ovrEngineered/ovrBeaconGateway-wifi-elec/bom/ovrBeaconGateway-wifi_pricing.xlsx

Sheet: Standalone Low-Power BTLE
Reference | Manufacturer | Man. Part Num. | Supplier | Supplier Part Num. | Quantity | Price (qty 1) | Subtotal (qty 1) | Price (qty 1000) | Subtotal (qty 1000)
J2 | Pulse Electronics | E6588-52L184-L | Digi-Key | 553-2265-ND | 0 | $1.40 | $0.00 | $0.774400 | $0.000000
U2 | Torex Semiconductor | XC6210B332MR-G | Digi-Key | 893-1075-1-ND | 1 | $0.88 | $0.88 | $0.351020 | $0.351020
D3 | Cree Inc. | CLV1A-FKB-CK1N1G1BB7R4S3 | Digi-Key | CLV1A-FKB-CK1N1G1BB7R4S3CT-ND | 1 | $0.74 | $0.74 | $0.486200 | $0.486200
U1 | Silicon Labs | SI7050-A20-IM | Digi-Key | 336-3118-5-ND | 1 | $1.25 | $1.25 | $0.939300 | $0.939300
U5 | Intersil | ISL32602EFBZ | Digi-Key | ISL32602EFBZ-ND | 0 | $3.18 | $0.00 | $1.680000 | $0.000000
U3 | FTDI | FT232RL | Digi-Key | 768-1007-1-ND | 1 | $4.50 | $4.50 | $2.850000 | $2.850000
R8 R9 R10 | Vishay_Dale | CRCW060312K0FKEA | Digi-Key | 541-12.0KHCT-ND | 3 | $0.10 | $0.30 | $0.005540 | $0.016620
C1 C2 C3 | Murata | GRM21BR71A106KE51L | Digi-Key | 490-3905-1-ND | 3 | $0.24 | $0.72 | $0.050500 | $0.151500
D1 | Lite-On Inc | LTST-C193KGKT-5A | Digi-Key | 160-1828-1-ND | 1 | $0.41 | $0.41 | $0.075650 | $0.075650
D2 | Lite-On Inc | LTST-C193KRKT-5A | Digi-Key | 160-1830-1-ND | 1 | $0.41 | $0.41 | $0.075650 | $0.075650
R3 R4 R5 R2 R1 R18 | Vishay_Dale | CRCW0603402RFKEA | Digi-Key | 541-402HCT-ND | 6 | $0.10 | $0.60 | $0.003610 | $0.021660
R11 | Vishay_Dale | CRCW06035K10FKEA | Digi-Key | 541-5.10KHCT-ND | 1 | $0.10 | $0.10 | $0.005540 | $0.005540
R13 R12 R7 R6 R15 R14 | Vishay_Dale | CRCW060310K0FKEA | Digi-Key | 541-10.0KHCT-ND | 2 | $0.10 | $0.20 | $0.003610 | $0.007220
Q3 | International Rectifier | DMC6040SSD-13 | Digi-Key | DMC6040SSD-13DICT-ND | 0 | $0.65 | $0.00 | $0.275550 | $0.000000
Q1 Q2 | Micro Commercial Co | MMSS8050-H-TP | Digi-Key | MMSS8050-H-TPMSCT-ND | 2 | $0.20 | $0.40 | $0.003954 | $0.007908
U4 | EspressIf | esp-wroom-32 | Grid Connect | GC-ESP-WROOM-32 | 1 | $3.95 | $3.95 | $3.950000 | $3.950000
D4 | Lite-On Inc | LTST-C193TBKT-5A | Digi-Key | 160-1827-1-ND | 1 | $0.47 | $0.47 | $0.085770 | $0.085770
J1 | CUI Inc | UJ2-MIBH-4-SMT | Digi-Key | 102-4006-1-ND | 1 | $1.05 | $1.05 | $0.649440 | $0.649440
U6 | BlueGiga | BLE121LR-A-M256K | Digi-Key | 1446-1039-1-ND | 0 | $13.76 | $0.00 | $8.312320 | $0.000000
C4 | Murata | GRM188R71C104KA01D | Digi-Key | 490-1532-1-ND | 0 | $0.10 | $0.00 | $0.004730 | $0.000000
LightPipe | Visual Communications Company | LFB100CTP | Digi-Key | LFB100CTP-ND | 4 | $0.59 | $2.36 | $0.144040 | $0.576160
Case | PolyCase | LP-41F | PolyCase | LP-41F | 1 | $3.36 | $3.36 | $2.250000 | $2.250000
Case Print/Machining | PolyCase |  |  |  | 1 |  |  | $4.890000 | $4.890000
PCB |  |  |  |  | 1 |  |  | $1.000000 | $1.000000
Assembly |  |  |  |  | 1 |  |  | $2.000000 | $2.000000
 |  |  |  |  |  | Total: | $21.70 |  | $20.39

Sheet: Standalone High-Power BTLE
Reference | Manufacturer | Man. Part Num. | Supplier | Supplier Part Num. | Quantity | Price (qty 1) | Subtotal (qty 1) | Price (qty 1000) | Subtotal (qty 1000)
J2 | Pulse Electronics | E6588-52L184-L | Digi-Key | 553-2265-ND | 0 | $1.40 | $0.00 | $0.774400 | $0.000000
U2 | Torex Semiconductor | XC6210B332MR-G | Digi-Key | 893-1075-1-ND | 1 | $0.88 | $0.88 | $0.351020 | $0.351020
D3 | Cree Inc. | CLV1A-FKB-CK1N1G1BB7R4S3 | Digi-Key | CLV1A-FKB-CK1N1G1BB7R4S3CT-ND | 1 | $0.74 | $0.74 | $0.486200 | $0.486200
U1 | Silicon Labs | SI7050-A20-IM | Digi-Key | 336-3118-5-ND | 1 | $1.25 | $1.25 | $0.939300 | $0.939300
U5 | Intersil | ISL32602EFBZ | Digi-Key | ISL32602EFBZ-ND | 0 | $3.18 | $0.00 | $1.680000 | $0.000000
U3 | FTDI | FT232RL | Digi-Key | 768-1007-1-ND | 1 | $4.50 | $4.50 | $2.850000 | $2.850000
R8 R9 R10 | Vishay_Dale | CRCW060312K0FKEA | Digi-Key | 541-12.0KHCT-ND | 3 | $0.10 | $0.30 | $0.005540 | $0.016620
C1 C2 C3 | Murata | GRM21BR71A106KE51L | Digi-Key | 490-3905-1-ND | 3 | $0.24 | $0.72 | $0.050500 | $0.151500
D1 | Lite-On Inc | LTST-C193KGKT-5A | Digi-Key | 160-1828-1-ND | 1 | $0.41 | $0.41 | $0.075650 | $0.075650
D2 | Lite-On Inc | LTST-C193KRKT-5A | Digi-Key | 160-1830-1-ND | 1 | $0.41 | $0.41 | $0.075650 | $0.075650
R3 R4 R5 R2 R1 R18 | Vishay_Dale | CRCW0603402RFKEA | Digi-Key | 541-402HCT-ND | 6 | $0.10 | $0.60 | $0.003610 | $0.021660
R11 | Vishay_Dale | CRCW06035K10FKEA | Digi-Key | 541-5.10KHCT-ND | 1 | $0.10 | $0.10 | $0.005540 | $0.005540
R13 R12 R7 R6 R15 R14 | Vishay_Dale | CRCW060310K0FKEA | Digi-Key | 541-10.0KHCT-ND | 2 | $0.10 | $0.20 | $0.003610 | $0.007220
Q3 | International Rectifier | DMC6040SSD-13 | Digi-Key | DMC6040SSD-13DICT-ND | 0 | $0.65 | $0.00 | $0.275550 | $0.000000
Q1 Q2 | Micro Commercial Co | MMSS8050-H-TP | Digi-Key | MMSS8050-H-TPMSCT-ND | 2 | $0.20 | $0.40 | $0.003954 | $0.007908
U4 | EspressIf | esp-wroom-32 | Grid Connect | GC-ESP-WROOM-32 | 1 | $3.95 | $3.95 | $3.950000 | $3.950000
D4 | Lite-On Inc | LTST-C193TBKT-5A | Digi-Key | 160-1827-1-ND | 1 | $0.47 | $0.47 | $0.085770 | $0.085770
J1 | CUI Inc | UJ2-MIBH-4-SMT | Digi-Key | 102-4006-1-ND | 1 | $1.05 | $1.05 | $0.649440 | $0.649440
U6 | BlueGiga | BLE121LR-A-M256K | Digi-Key | 1446-1039-1-ND | 1 | $13.76 | $13.76 | $8.312320 | $8.312320
C4 | Murata | GRM188R71C104KA01D | Digi-Key | 490-1532-1-ND | 1 | $0.10 | $0.10 | $0.004730 | $0.004730
LightPipe | Visual Communications Company | LFB100CTP | Digi-Key | LFB100CTP-ND | 4 | $0.59 | $2.36 | $0.144040 | $0.576160
Case | PolyCase | LP-41F | PolyCase | LP-41F | 1 | $3.36 | $3.36 | $2.250000 | $2.250000
Case Print/Machining | PolyCase |  |  |  | 1 |  |  | $4.890000 | $4.890000
PCB |  |  |  |  | 1 |  |  | $1.000000 | $1.000000
Assembly |  |  |  |  | 1 |  |  | $2.000000 | $2.000000
 |  |  |  |  |  | Total: | $35.56 |  | $28.71

Sheet: External BTLE Extension
Reference | Manufacturer | Man. Part Num. | Supplier | Supplier Part Num. | Quantity | Price (qty 1) | Subtotal (qty 1) | Price (qty 1000) | Subtotal (qty 1000)
J2 | Pulse Electronics | E6588-52L184-L | Digi-Key | 553-2265-ND | 1 | $1.40 | $1.40 | $0.774400 | $0.774400
U2 | Torex Semiconductor | XC6210B332MR-G | Digi-Key | 893-1075-1-ND | 1 | $0.88 | $0.88 | $0.351020 | $0.351020
D3 | Cree Inc. | CLV1A-FKB-CK1N1G1BB7R4S3 | Digi-Key | CLV1A-FKB-CK1N1G1BB7R4S3CT-ND | 1 | $0.74 | $0.74 | $0.486200 | $0.486200
U1 | Silicon Labs | SI7050-A20-IM | Digi-Key | 336-3118-5-ND | 1 | $1.25 | $1.25 | $0.939300 | $0.939300
U5 | Intersil | ISL32602EFBZ | Digi-Key | ISL32602EFBZ-ND | 1 | $3.18 | $3.18 | $1.680000 | $1.680000
U3 | FTDI | FT232RL | Digi-Key | 768-1007-1-ND | 1 | $4.50 | $4.50 | $2.850000 | $2.850000
R8 R9 R10 | Vishay_Dale | CRCW060312K0FKEA | Digi-Key | 541-12.0KHCT-ND | 3 | $0.10 | $0.30 | $0.005540 | $0.016620
C1 C2 C3 | Murata | GRM21BR71A106KE51L | Digi-Key | 490-3905-1-ND | 3 | $0.24 | $0.72 | $0.050500 | $0.151500
D1 | Lite-On Inc | LTST-C193KGKT-5A | Digi-Key | 160-1828-1-ND | 1 | $0.41 | $0.41 | $0.075650 | $0.075650
D2 | Lite-On Inc | LTST-C193KRKT-5A | Digi-Key | 160-1830-1-ND | 1 | $0.41 | $0.41 | $0.075650 | $0.075650
R3 R4 R5 R2 R1 R18 | Vishay_Dale | CRCW0603402RFKEA | Digi-Key | 541-402HCT-ND | 6 | $0.10 | $0.60 | $0.003610 | $0.021660
R11 | Vishay_Dale | CRCW06035K10FKEA | Digi-Key | 541-5.10KHCT-ND | 1 | $0.10 | $0.10 | $0.005540 | $0.005540
R13 R12 R7 R6 R15 R14 | Vishay_Dale | CRCW060310K0FKEA | Digi-Key | 541-10.0KHCT-ND | 6 | $0.10 | $0.60 | $0.003610 | $0.021660
Q3 | International Rectifier | DMC6040SSD-13 | Digi-Key | DMC6040SSD-13DICT-ND | 1 | $0.65 | $0.65 | $0.275550 | $0.275550
Q1 Q2 | Micro Commercial Co | MMSS8050-H-TP | Digi-Key | MMSS8050-H-TPMSCT-ND | 2 | $0.20 | $0.40 | $0.003954 | $0.007908
U4 | EspressIf | esp-wroom-32 | Grid Connect | GC-ESP-WROOM-32 | 1 | $3.95 | $3.95 | $3.950000 | $3.950000
D4 | Lite-On Inc | LTST-C193TBKT-5A | Digi-Key | 160-1827-1-ND | 1 | $0.47 | $0.47 | $0.085770 | $0.085770
J1 | CUI Inc | UJ2-MIBH-4-SMT | Digi-Key | 102-4006-1-ND | 1 | $1.05 | $1.05 | $0.649440 | $0.649440
U6 | BlueGiga | BLE121LR-A-M256K | Digi-Key | 1446-1039-1-ND | 0 | $13.76 | $0.00 | $8.312320 | $0.000000
C4 | Murata | GRM188R71C104KA01D | Digi-Key | 490-1532-1-ND | 0 | $0.10 | $0.00 | $0.004730 | $0.000000
LightPipe | Visual Communications Company | LFB100CTP | Digi-Key | LFB100CTP-ND | 4 | $0.59 | $2.36 | $0.144040 | $0.576160
Case | PolyCase | LP-41F | PolyCase | LP-41F | 1 | $3.36 | $3.36 | $2.250000 | $2.250000
Case Print/Machining | PolyCase |  |  |  | 1 |  |  | $4.890000 | $4.890000
PCB |  |  |  |  | 1 |  |  | $1.000000 | $1.000000
Assembly |  |  |  |  | 1 |  |  | $2.000000 | $2.000000
 |  |  |  |  |  | Total: | $27.33 |  | $23.13
