ovrEngineered/ovrBeaconGateway-wifi-elec/output/ovrBeaconGateway-wifi_schematic.pdf

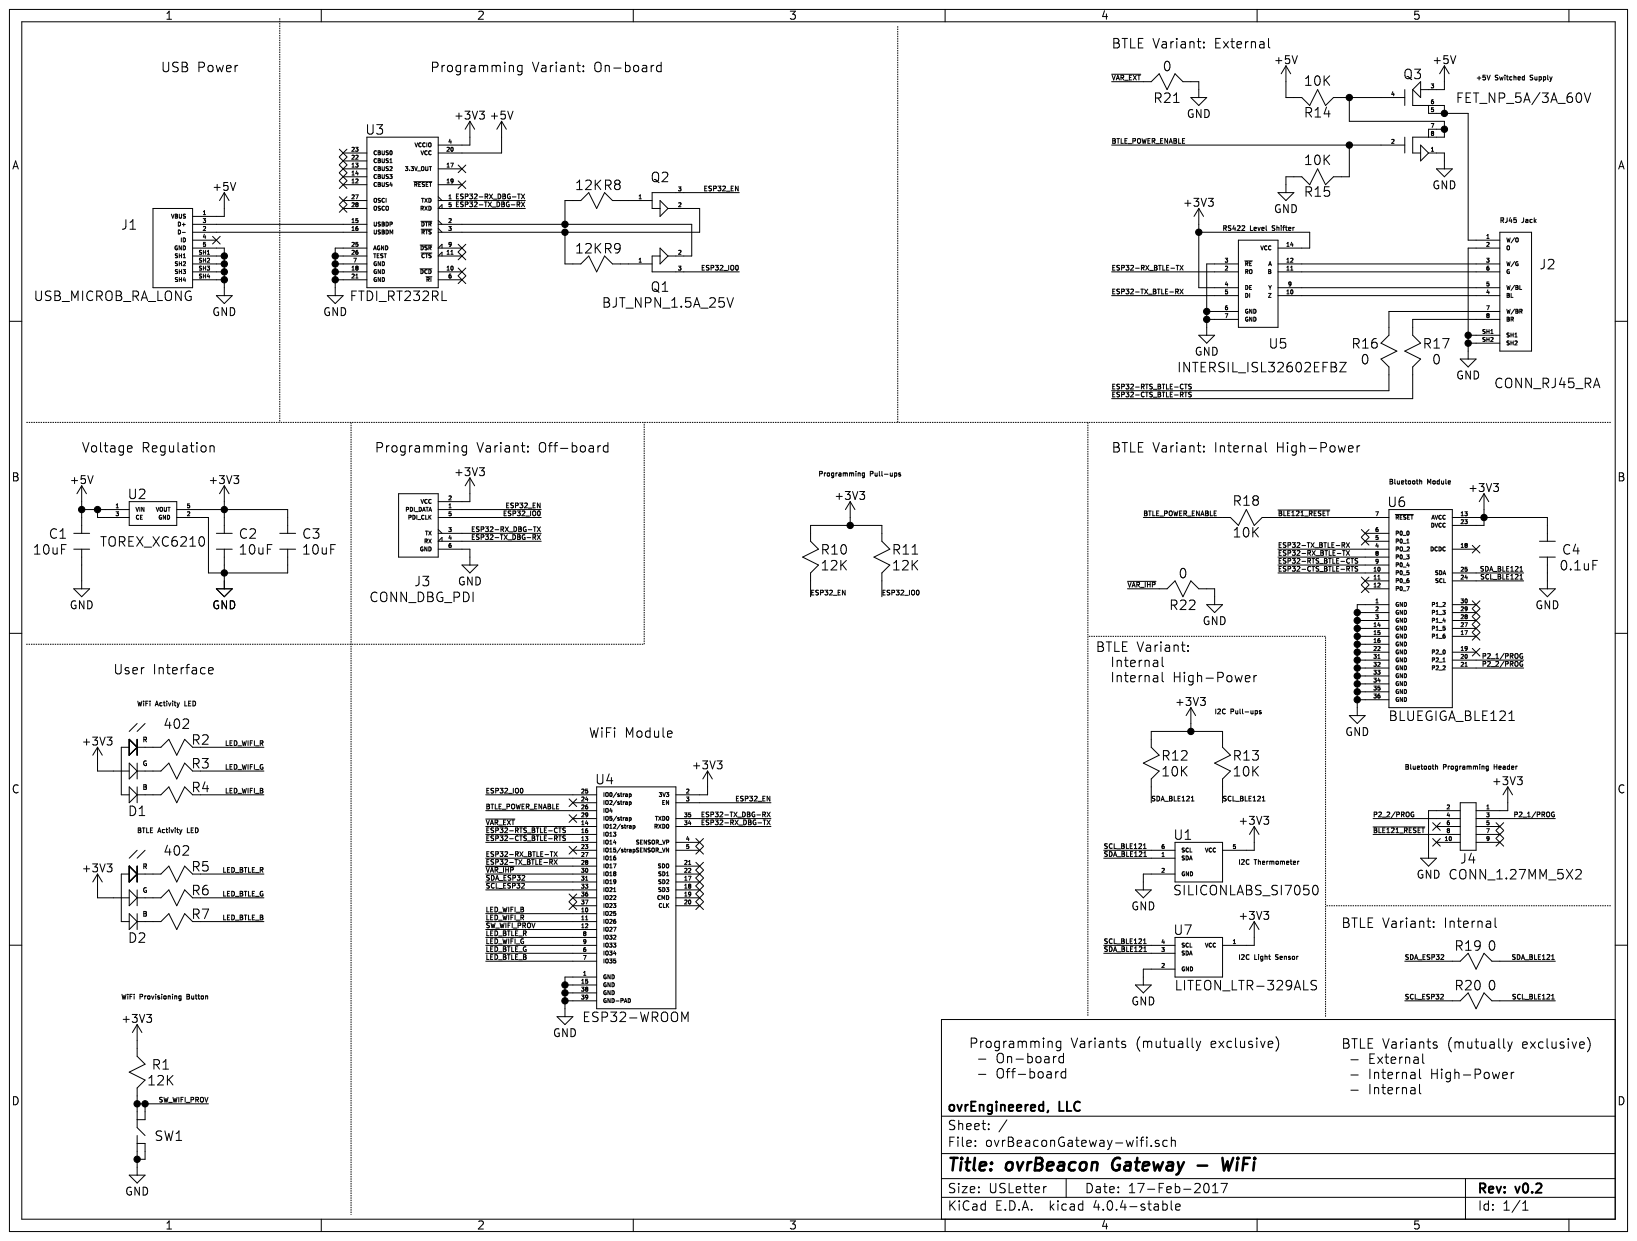
[picture p1: page 1]
