ovrEngineered/ovrBeaconGateway-wifi-elec/output/ovrBeaconGateway-wifi_layout.pdf

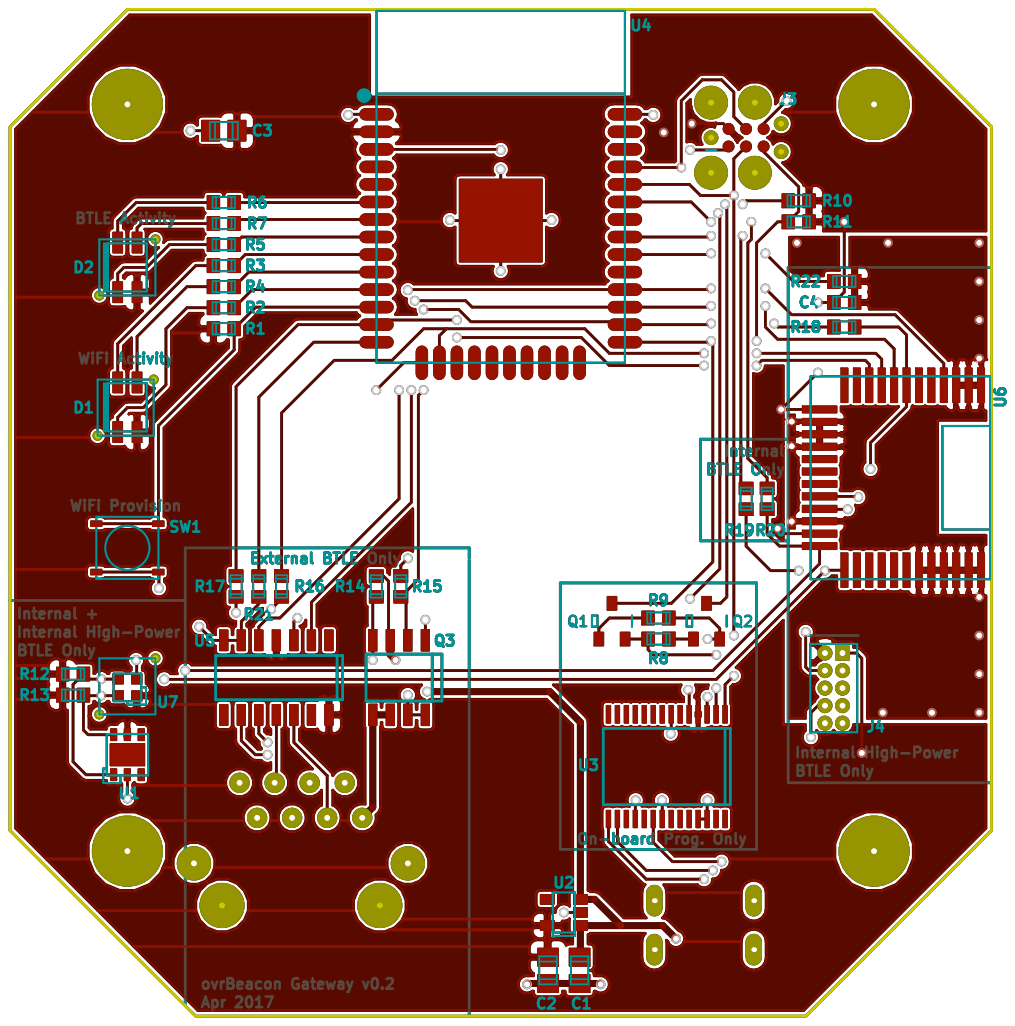
[picture p2: page 1]
