ovrEngineered/ovrBeaconGateway-wifi-elec/ovrBeaconGateway-wifi.kicad_pcb

## KiCad design ovrBeaconGateway-wifi.kicad_pcb (2017-05-01)

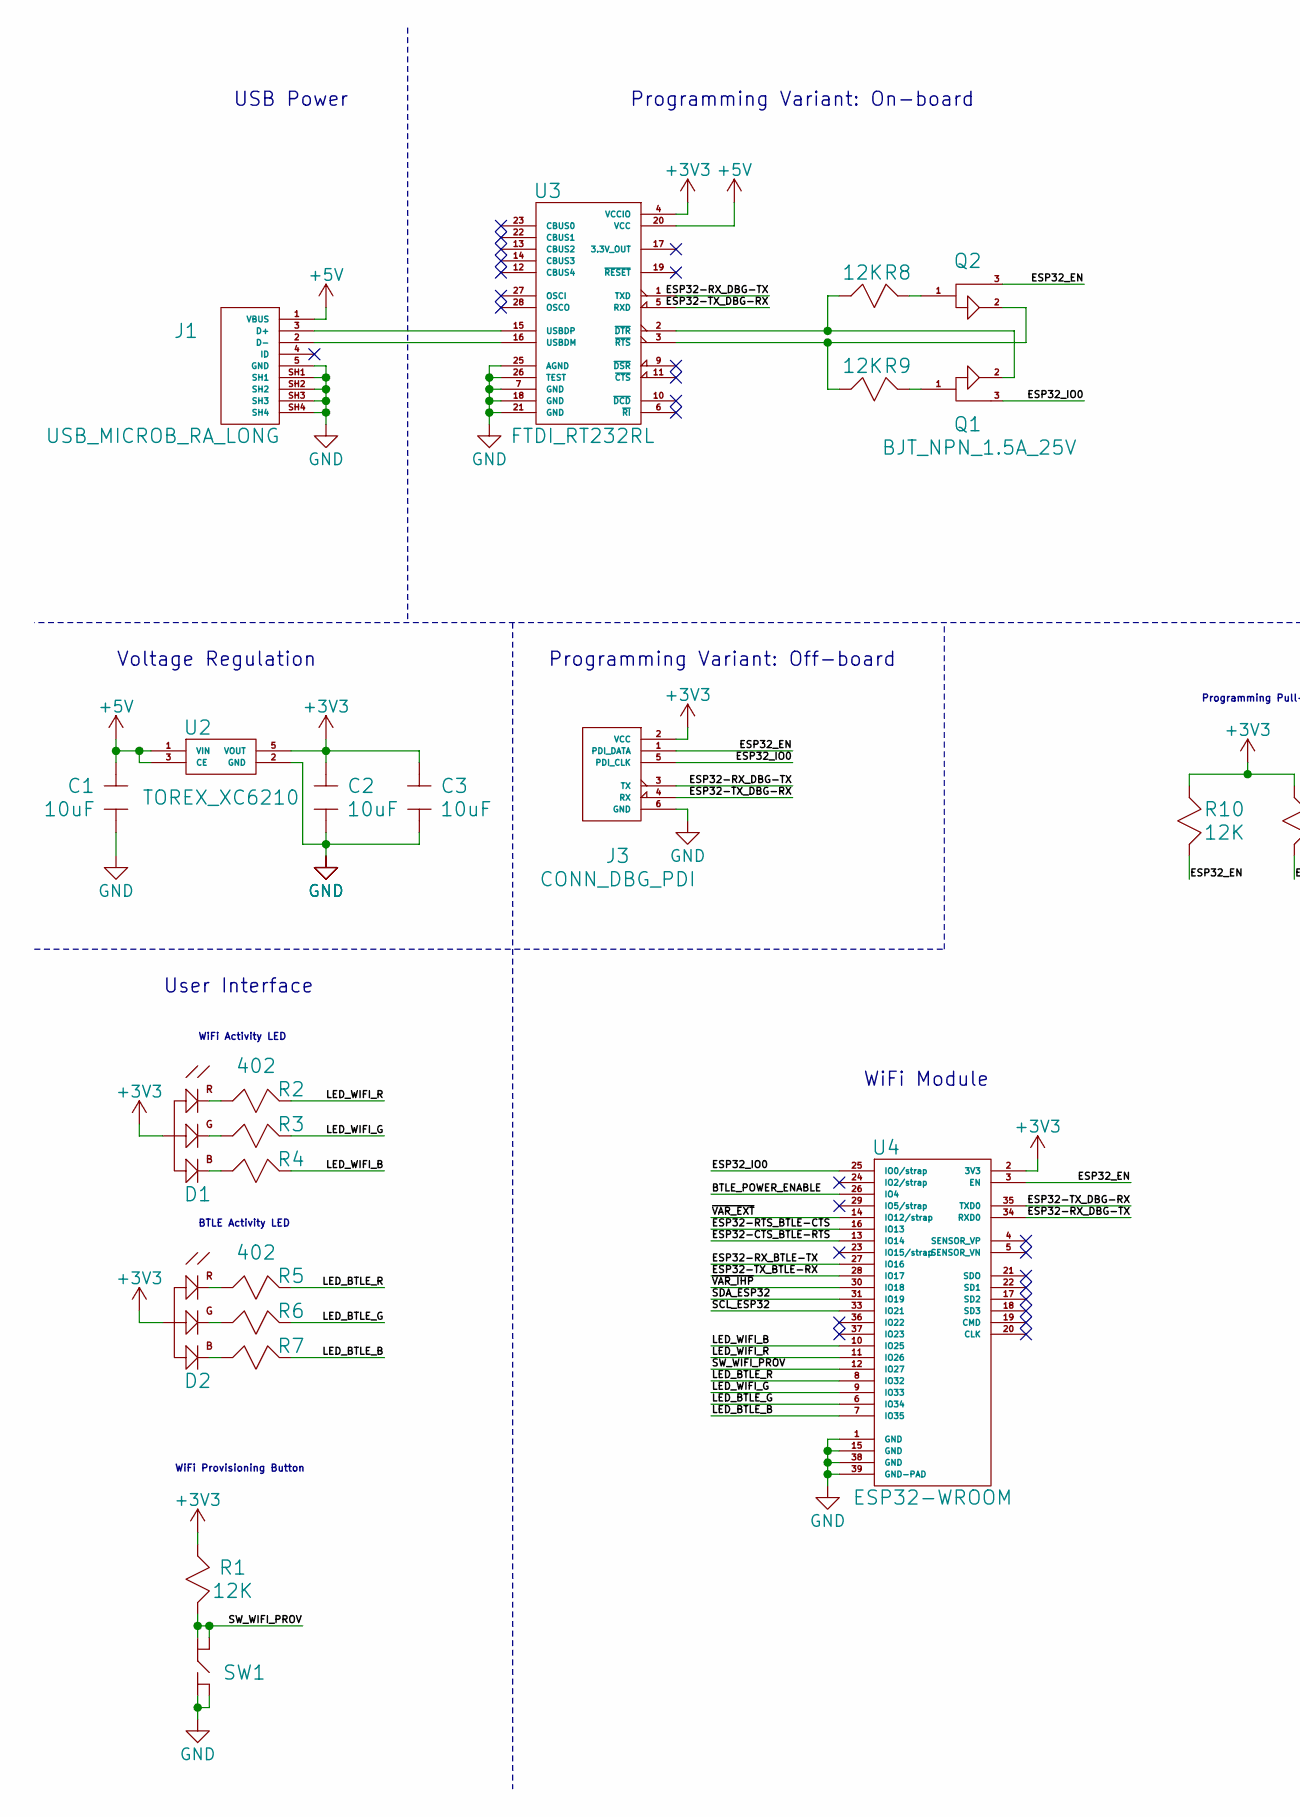
[picture p3: schematic ovrBeaconGateway-wifi.sch, ovrBeacon Gateway - WiFi, part in row 1, column 1]

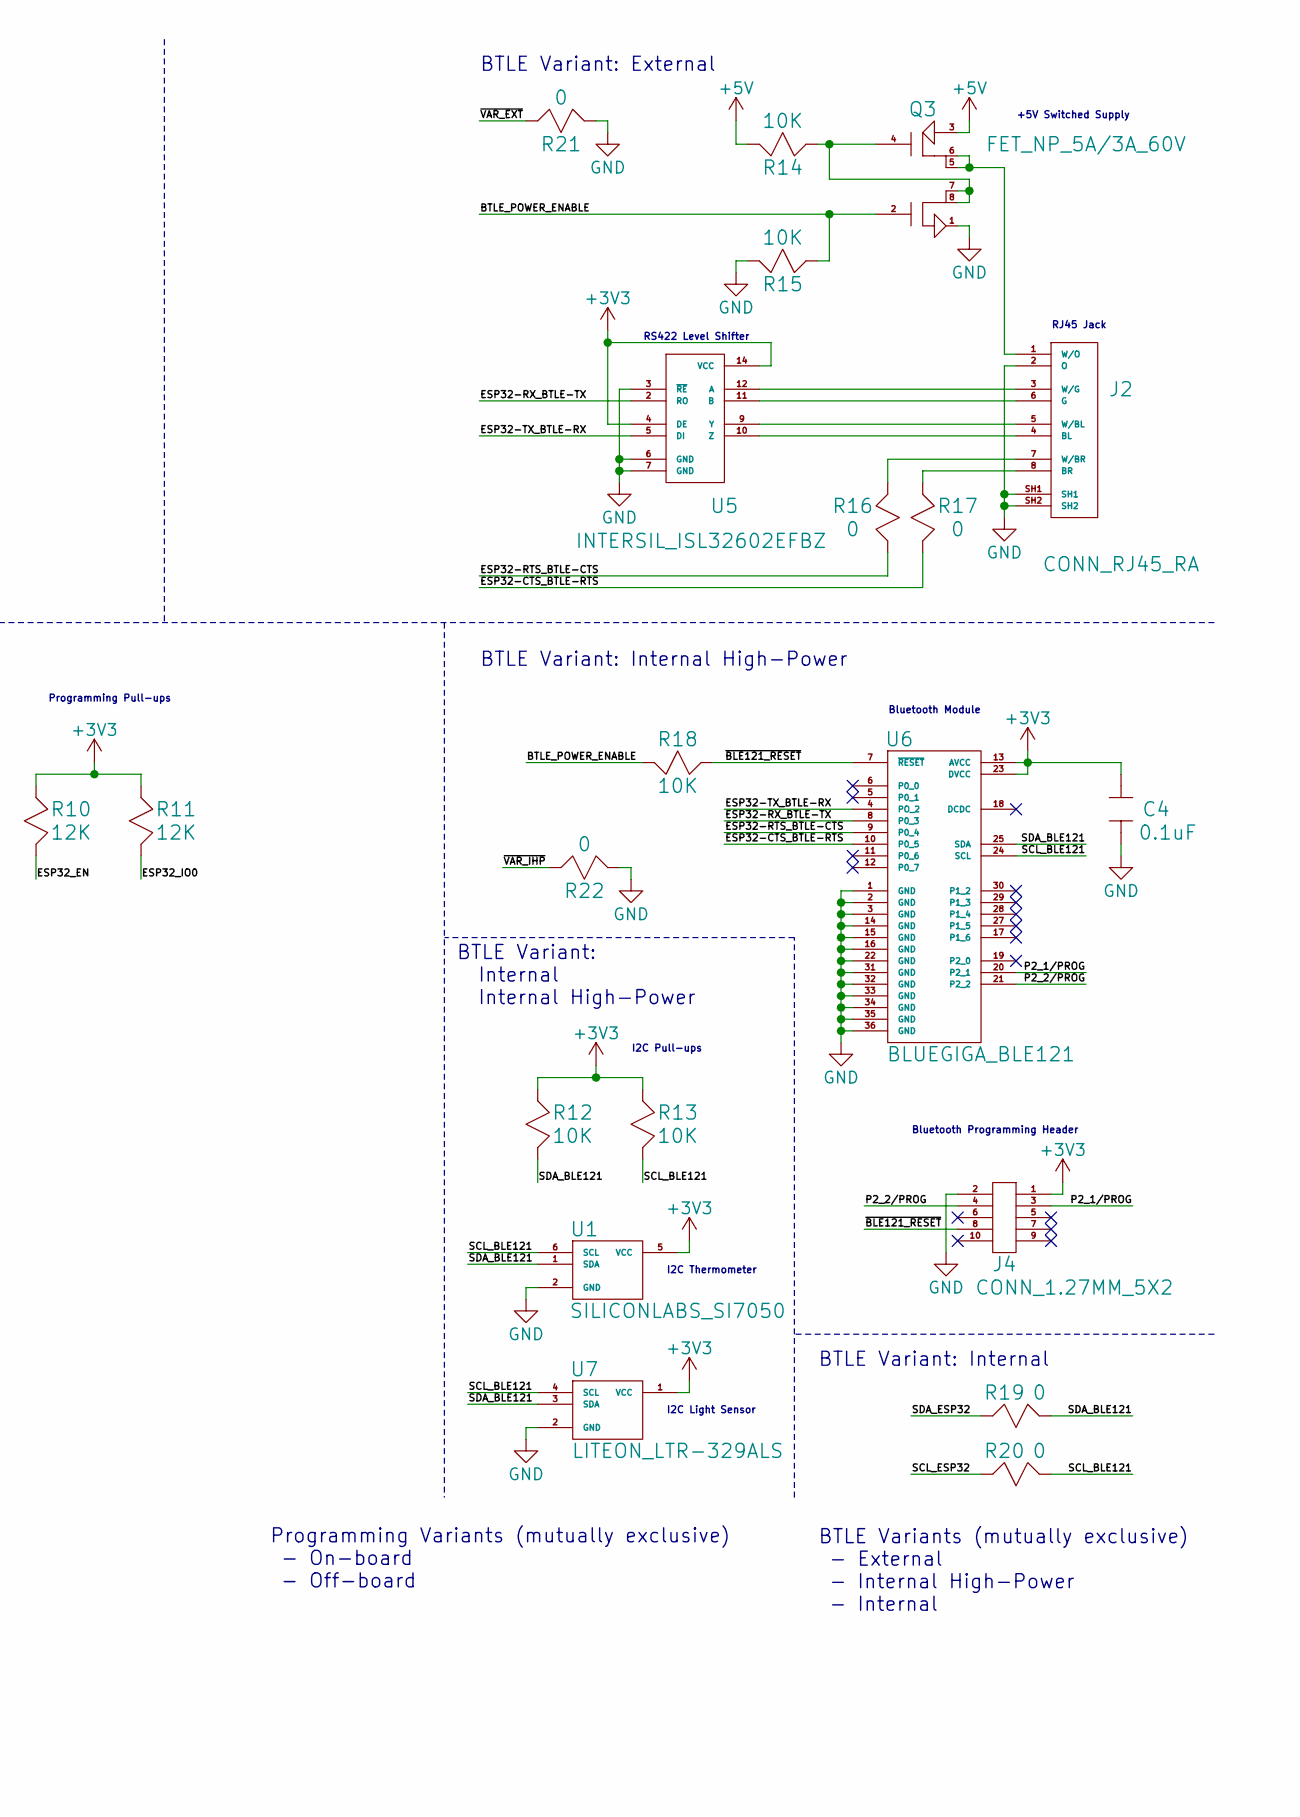
[picture p4: schematic ovrBeaconGateway-wifi.sch, ovrBeacon Gateway - WiFi, part in row 1, column 2]

Parts:
C1, C2, C3: C_10uF_10v_0805; C_0805; Man. Part Num. GRM21BR71A106KE51L
C4: C_0.1uF_10v_0603; C_0603; Man. Part Num. GRM188R71C104KA01D
D1, D2: CREE_CLV1A_FKB; Man. Part Num. CLV1A-FKB-CK1N1G1BB7R4S3
J1: USB_MICROB_RA_LONG; UJ2-MIBH-4-SMT; Man. Part Num. UJ2-MIBH-4-SMT
J2: CONN_RJ45_RA; RJ45_NOMAG_RA; Man. Part Num. E6588-52L184-L
J3: CONN_DBG_PDI; TC2030-IDC; Man. Part Num. TC2030-IDC
J4: CONN_1.27MM_5X2; 20021111-00010T4LF; Man. Part Num. 20021111-00010T4LF
Q1, Q2: BJT_NPN_1.5A_25V; SOT-23-3; Man. Part Num. MMSS8050-H-TP
Q3: FET_NP_5A/3A_60V; SO-8; Man. Part Num. DMC6040SSD-13
R1, R8, R9, R10, R11: R_12K_1%_0603; R_0603; Man. Part Num. CRCW060312K0FKEA
R2, R3, R4, R5, R6, R7: R_402_1%_0603; R_0603; Man. Part Num. CRCW0603402RFKEA
R12, R13, R14, R15, R18: R_10K_1%_0603; R_0603; Man. Part Num. CRCW060310K0FKEA
R16, R17, R19, R20, R21, R22: R_0_0603; R_0603; Man. Part Num. CRCW06030000Z0EA
SW1: ESWITCH_TL3315NF100Q; TL3315NF100Q; Man. Part Num. TL3315NF100Q
U1: SILICONLABS_SI7050; Man. Part Num. SI7050-A20-IM
U2: TOREX_XC6210; SOT-25-5; Man. Part Num. XC6210B332MR-G
U3: FTDI_RT232RL; FT232RL; Man. Part Num. FT232RL
U4: ESP32-WROOM; Man. Part Num. esp-wroom-32
U5: INTERSIL_ISL32602EFBZ; SOIC-14; Man. Part Num. ISL32602EFBZ
U6: BLUEGIGA_BLE121; BLE121; Man. Part Num. BLE121LR-A-M256K
U7: LITEON_LTR-329ALS; Man. Part Num. LTR-329ALS-01

Connections:
+3V3: C2.1, C3.1, C4.1, D1.2 (ANODE), D2.2 (ANODE), J3.2 (VCC), J4.1, R1.1, R10.1, R11.1, R12.1, R13.1, U1.5 (VCC), U2.5 (VOUT), U3.4 (VCCIO), U4.2 (3V3), U5.4 (DE), U5.14 (VCC), U6.13 (AVCC), U6.23 (DVCC), U7.1 (VCC)
+5V: C1.1, J1.1 (VBUS), Q3.3, R14.2, U2.1 (VIN), U2.3 (CE), U3.20 (VCC)
/BTLE_POWER_ENABLE: Q3.2, R15.1, R18.2, U4.26 (IO4)
/ESP32-CTS_BTLE-RTS: R17.2, U4.13 (IO14), U6.10 (P0_5)
/ESP32-RTS_BTLE-CTS: R16.2, U4.16 (IO13), U6.9 (P0_4)
/ESP32-RX_BTLE-TX: U4.27 (IO16), U5.2 (RO), U6.8 (P0_3)
/ESP32-RX_DBG-TX: J3.3 (TX), U3.1 (TXD), U4.34 (RXD0)
/ESP32-TX_BTLE-RX: U4.28 (IO17), U5.5 (DI), U6.4 (PO_2)
/ESP32-TX_DBG-RX: J3.4 (RX), U3.5 (RXD), U4.35 (TXD0)
/ESP32_EN: J3.1 (PDI_DATA), Q2.3, R10.2, U4.3 (EN)
/ESP32_IO0: J3.5 (PDI_CLK), Q1.3, R11.2, U4.25 (IO0/strap)
/LED_BTLE_B: R7.2, U4.7 (IO35)
/LED_BTLE_G: R6.2, U4.6 (IO34)
/LED_BTLE_R: R5.2, U4.8 (IO32)
/LED_WIFI_B: R4.2, U4.10 (IO25)
/LED_WIFI_G: R3.2, U4.9 (IO33)
/LED_WIFI_R: R2.2, U4.11 (IO26)
/P2_1/PROG: J4.3, U6.20 (P2_1)
/P2_2/PROG: J4.4, U6.21 (P2_2)
/SCL_BLE121: R13.2, R20.2, U1.6 (SCL), U6.24 (SCL), U7.4 (SCL)
/SCL_ESP32: R20.1, U4.33 (IO21)
/SDA_BLE121: R12.2, R19.2, U1.1 (SDA), U6.25 (SDA), U7.3 (SDA)
/SDA_ESP32: R19.1, U4.31 (IO19)
/SW_WIFI_PROV: R1.2, SW1.1, SW1.2, U4.12 (IO27)
/~BLE121_RESET: J4.8, R18.1, U6.7 (~RESET)
/~VAR_EXT: R21.1, U4.14 (IO12/strap)
/~VAR_IHP: R22.1, U4.30 (IO18)
GND: C1.2, C2.2, C3.2, C4.2, J1.5 (GND), J1.SH1, J1.SH2, J1.SH3, J1.SH4, J2.2 (O), J2.SH1, J2.SH2, J3.6 (GND), J4.2, Q3.1, R15.2, R21.2, R22.2, SW1.3, SW1.4, U1.2 (GND), U2.2 (GND), U3.7 (GND), U3.18 (GND), U3.21 (GND), U3.25 (AGND), U3.26 (TEST), U4.1 (GND), U4.15 (GND), U4.38 (GND), U4.39 (GND-PAD), U5.3 (~RE), U5.6 (GND), U5.7 (GND), U6.1 (GND), U6.2 (GND), U6.3 (GND), U6.14 (GND), U6.15 (GND), U6.16 (GND), U6.22 (GND), U6.31 (GND), U6.32 (GND), U6.33 (GND), U6.34 (GND), U6.35 (GND), U6.36 (GND), U7.2 (GND)
unnamed: D1.1 (CATHODE_RED), R2.1
unnamed: D1.3 (CATHODE_BLUE), R4.1
unnamed: D1.4 (CATHOD_GREEN), R3.1
unnamed: D2.1 (CATHODE_RED), R5.1
unnamed: D2.3 (CATHODE_BLUE), R7.1
unnamed: D2.4 (CATHOD_GREEN), R6.1
unnamed: J1.2 (D-), U3.16 (USBDM)
unnamed: J1.3 (D+), U3.15 (USBDP)
unnamed: J2.1 (W/O), Q3.5, Q3.6
unnamed: J2.3 (W/G), U5.12 (A)
unnamed: J2.4 (BL), U5.10 (Z)
unnamed: J2.5 (W/BL), U5.9 (Y)
unnamed: J2.6 (G), U5.11 (B)
unnamed: J2.7 (W/BR), R16.1
unnamed: J2.8 (BR), R17.1
unnamed: Q1.1, R9.2
unnamed: Q1.2, R8.1, U3.2 (~DTR)
unnamed: Q2.1, R8.2
unnamed: Q2.2, R9.1, U3.3 (~RTS)
unnamed: Q3.4, Q3.7, Q3.8, R14.1

Notes on the sheet:
USB Power
BTLE Variant: External
Voltage Regulation
WiFi Module
BTLE Variant: Internal High-Power
Programming Variant: Off-board
Programming Variant: On-board
+5V Switched Supply
BTLE Variants (mutually exclusive) - External - Internal High-Power - Internal
RS422 Level Shifter
RJ45 Jack
Bluetooth Module
Bluetooth Programming Header
I2C Thermometer
BTLE Variant: Internal
Programming Variants (mutually exclusive) - On-board - Off-board
Programming Pull-ups
BTLE Variant: Internal Internal High-Power
I2C Light Sensor
I2C Pull-ups
WiFi Activity LED
BTLE Activity LED
WiFi Provisioning Button
User Interface

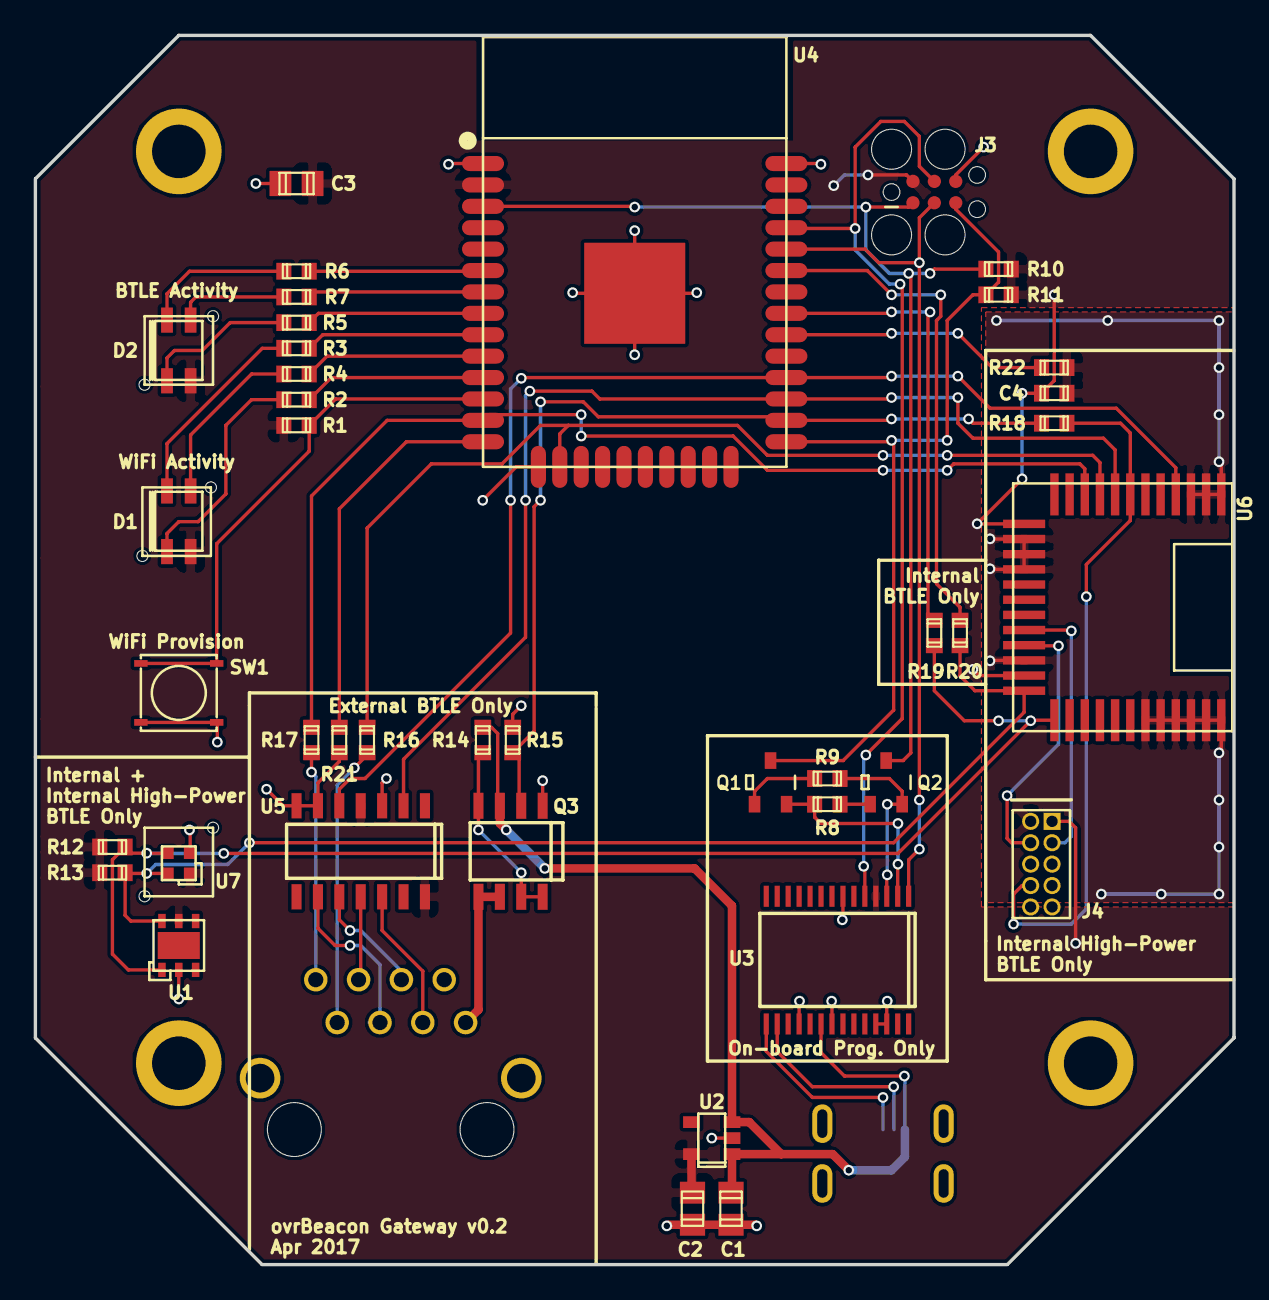
[picture p5: board ovrBeaconGateway-wifi.kicad_pcb from above]

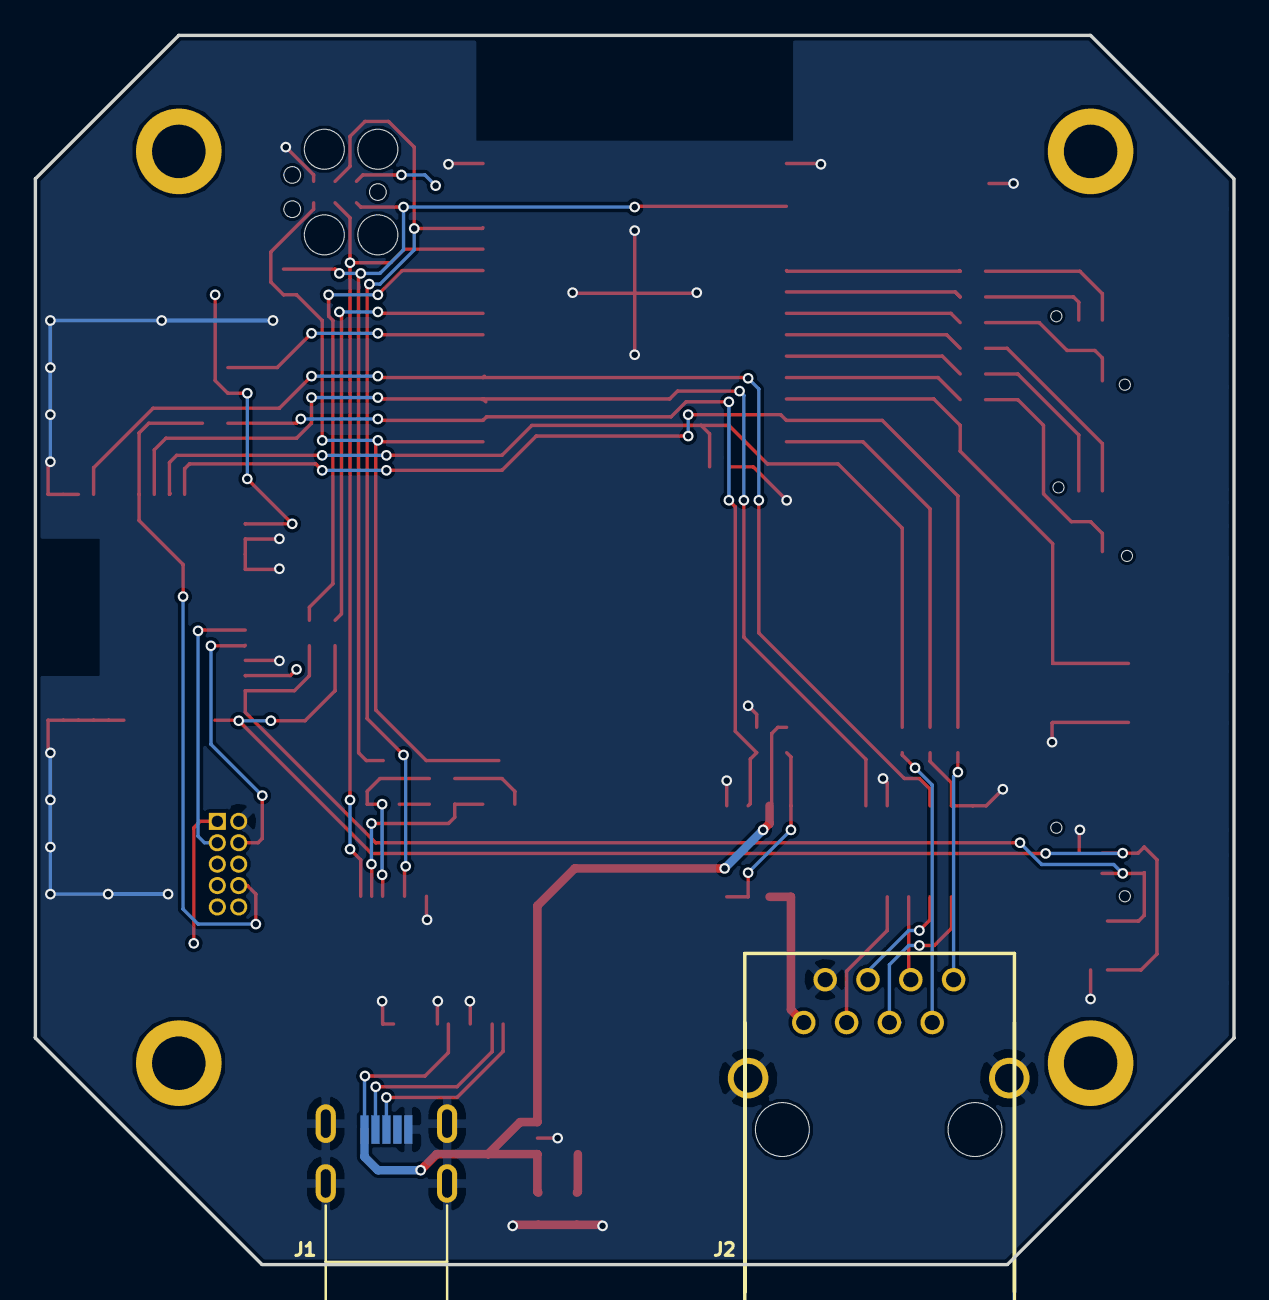
[picture p6: board ovrBeaconGateway-wifi.kicad_pcb from below]

Board: 2 copper layers, 71.1 x 72.9 mm, 43 parts (2 on the bottom side), 48 nets.
