ovrEngineered/ovrBeaconGateway-wifi-elec/(commit log)

2017-02-18 Moved BOM added current pricing, ready for manufacture
    [ovrBeaconGateway-wifi_BOM.csv, ovrBeaconGateway-wifi_pricing.xlsx]
2017-02-24 Included an optional BLE121 on this module to allow for stand-alone long range operation
    [ovrBeaconGateway-wifi-B.Cu.gbr, ovrBeaconGateway-wifi-B.Mask.gbr, ovrBeaconGateway-wifi-B.SilkS.gbr, ovrBeaconGateway-wifi-Edge.Cuts.gbr, ovrBeaconGateway-wifi-F.Cu.gbr, ovrBeaconGateway-wifi-F.Mask.gbr, ovrBeaconGateway-wifi-F.SilkS.gbr, ovrBeaconGateway-wifi-NPTH.drl]
2017-02-24 Updated BOM and pricing…still waiting for quote on BLE121
    [ovrBeaconGateway-wifi_BOM.csv, ovrBeaconGateway-wifi_pricing.xlsx]
2017-02-26 Added PDF schematic
2017-02-26 Added price for BLE121
    [ovrBeaconGateway-wifi_pricing.xlsx]
2017-03-07 Updated pricing document w/ variants
    [ovrBeaconGateway-wifi_pricing.xlsx]
2017-04-24 Initial commit of second revision changes
    [ovrBeaconGateway-wifi.kicad_pcb, ovrBeaconGateway-wifi.sch]
2017-04-25 updated BOM
    [ovrBeaconGateway-wifi_BOM.csv]
2017-04-25 Fixed field offset and removed tag-connect programming port
    [ovrBeaconGateway-wifi_BOM.csv]
2017-05-01 Out for DFM
    [ovrBeaconGateway-wifi-B.Cu.gbr, ovrBeaconGateway-wifi-B.Mask.gbr, ovrBeaconGateway-wifi-B.SilkS.gbr, ovrBeaconGateway-wifi-Edge.Cuts.gbr, ovrBeaconGateway-wifi-F.Cu.gbr, ovrBeaconGateway-wifi-F.Mask.gbr, ovrBeaconGateway-wifi-F.SilkS.gbr, ovrBeaconGateway-wifi-NPTH.drl]
2017-05-01 Added schematic and layout
